buteomont/Acceleration-Logger/resources/FreeCAD/Acceleration Logger.step

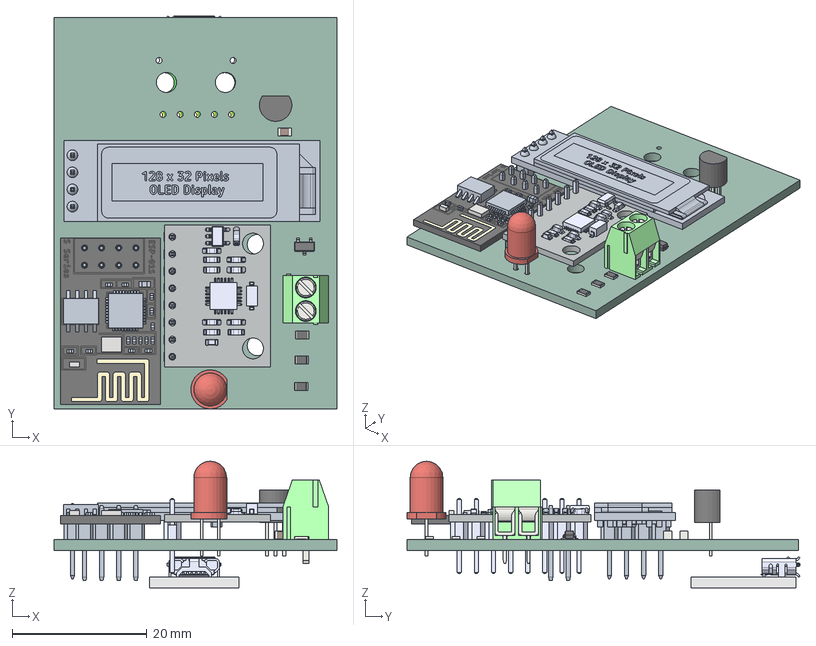
[picture p1: CAD file, 2025-04-22]
resources/FreeCAD/Acceleration Logger.step
42.0 x 58.3 x 18.8 mm
R_0805_2012Metric x 3
C_0805_2012Metric x 2
mpu
ESP-01S (ESP8266) Board Module v5
TO-92_Inline_Narrow
LED_D5.0mm
PCB_Terminal_Block_2-P3.5
SOT_23
Mico-USB_Breakout
Acceleration Logger_PCB
