buteomont/Acceleration-Logger/resources/FreeCAD/acceleration recorder-Bottom.stl

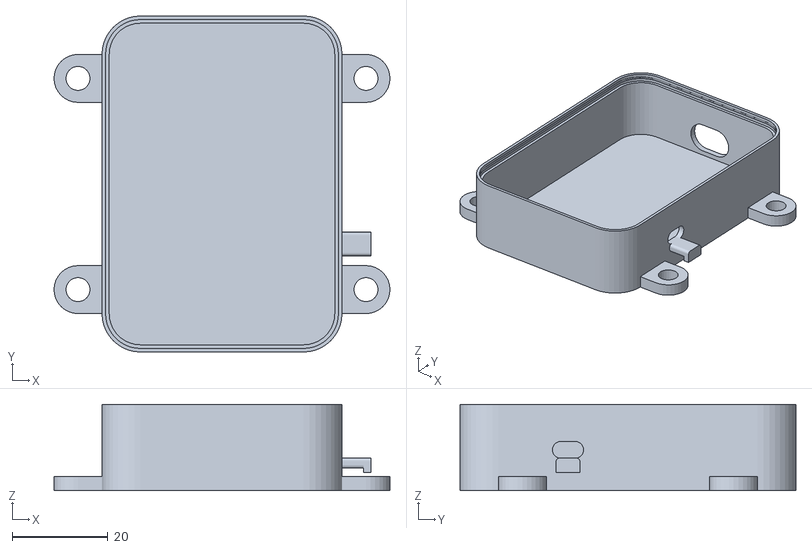
[picture p2: CAD file, 2025-04-22]
resources/FreeCAD/acceleration recorder-Bottom.stl
70.0 x 70.0 x 18.0
