buteomont/Acceleration-Logger/resources/FreeCAD/acceleration recorder-Top.stl

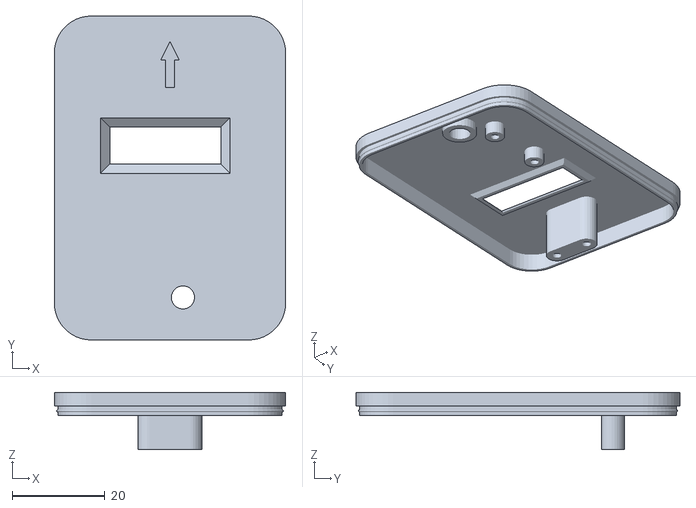
[picture p3: CAD file, 2025-04-22]
resources/FreeCAD/acceleration recorder-Top.stl
50.0 x 70.0 x 12.4
