buteomont/Acceleration-Logger/resources/FreeCAD/Standoffs-Sensor.stl

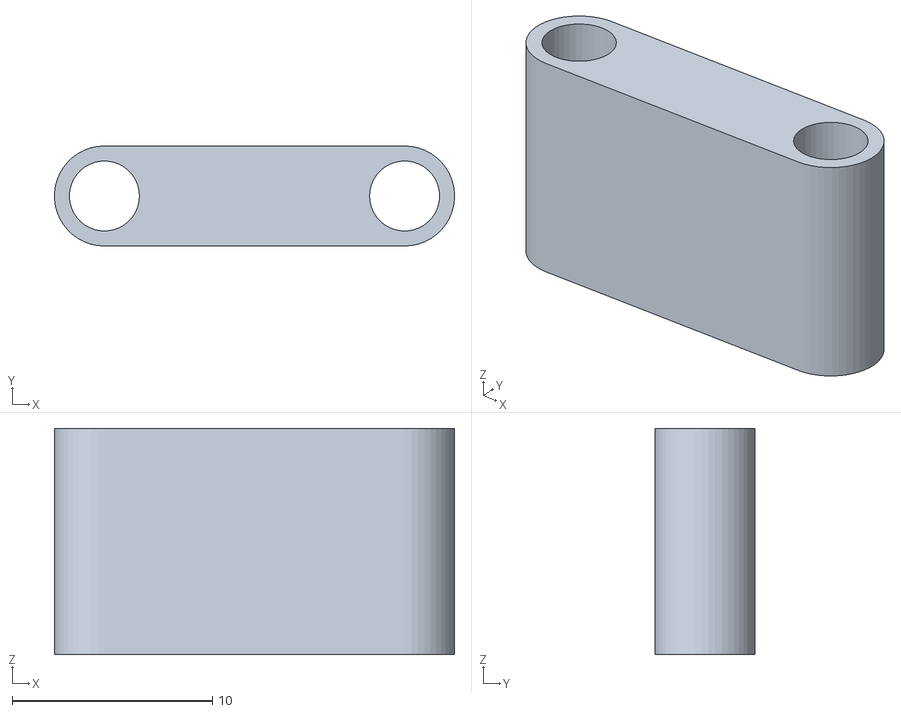
[picture p4: CAD file, 2025-03-28]
resources/FreeCAD/Standoffs-Sensor.stl
20.0 x 5.00 x 11.3
