buteomont/Acceleration-Logger/resources/FreeCAD/Standoffs-Display.stl

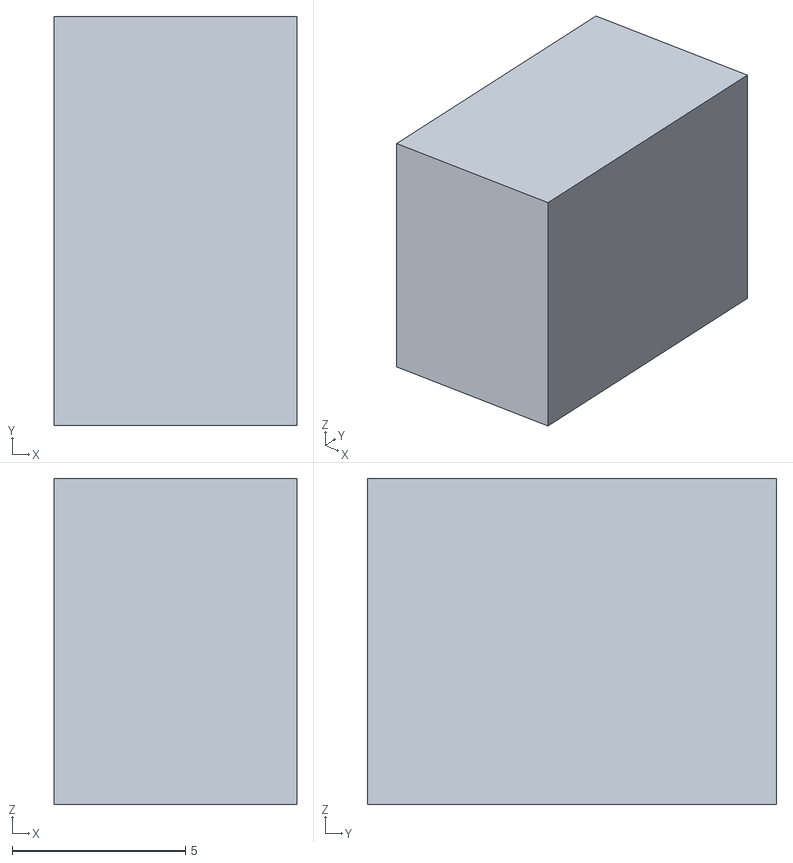
[picture p5: CAD file, 2025-03-28]
resources/FreeCAD/Standoffs-Display.stl
7.00 x 11.8 x 9.40
