buteomont/Acceleration-Logger/resources/FreeCAD/Standoffs.FCStd

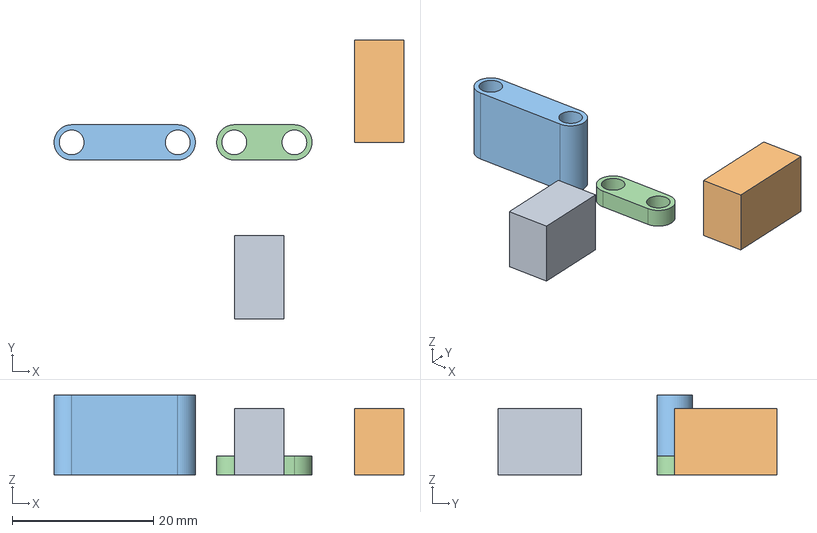
[picture p6: CAD file, 2025-03-28]
resources/FreeCAD/Standoffs.FCStd
49.5 x 39.5 x 11.3 mm
Display
Processor
Sensor
USB
