buteomont/Acceleration-Logger/resources/FreeCAD/Standoffs-USB.stl

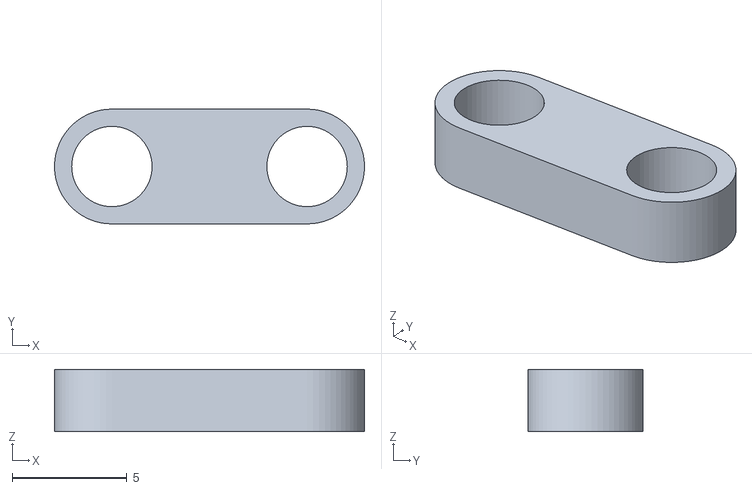
[picture p7: CAD file, 2025-03-28]
resources/FreeCAD/Standoffs-USB.stl
13.5 x 5.00 x 2.70
