buteomont/Acceleration-Logger/resources/FreeCAD/Standoffs-Processor.stl

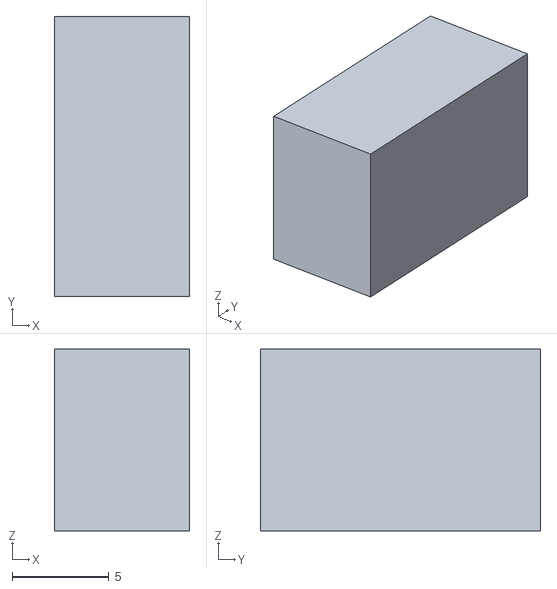
[picture p8: CAD file, 2025-03-28]
resources/FreeCAD/Standoffs-Processor.stl
7.00 x 14.5 x 9.40
