buteomont/Acceleration-Logger/(list of files, cad)

Other CAD files:
resources/FreeCAD/acceleration recorder.FCStd
