buteomont/Acceleration-Logger/resources/kicad/Acceleration Logger/Acceleration Logger.kicad_pcb

## KiCad design resources/kicad/Acceleration Logger/Acceleration Logger.kicad_pcb (2025-04-22)

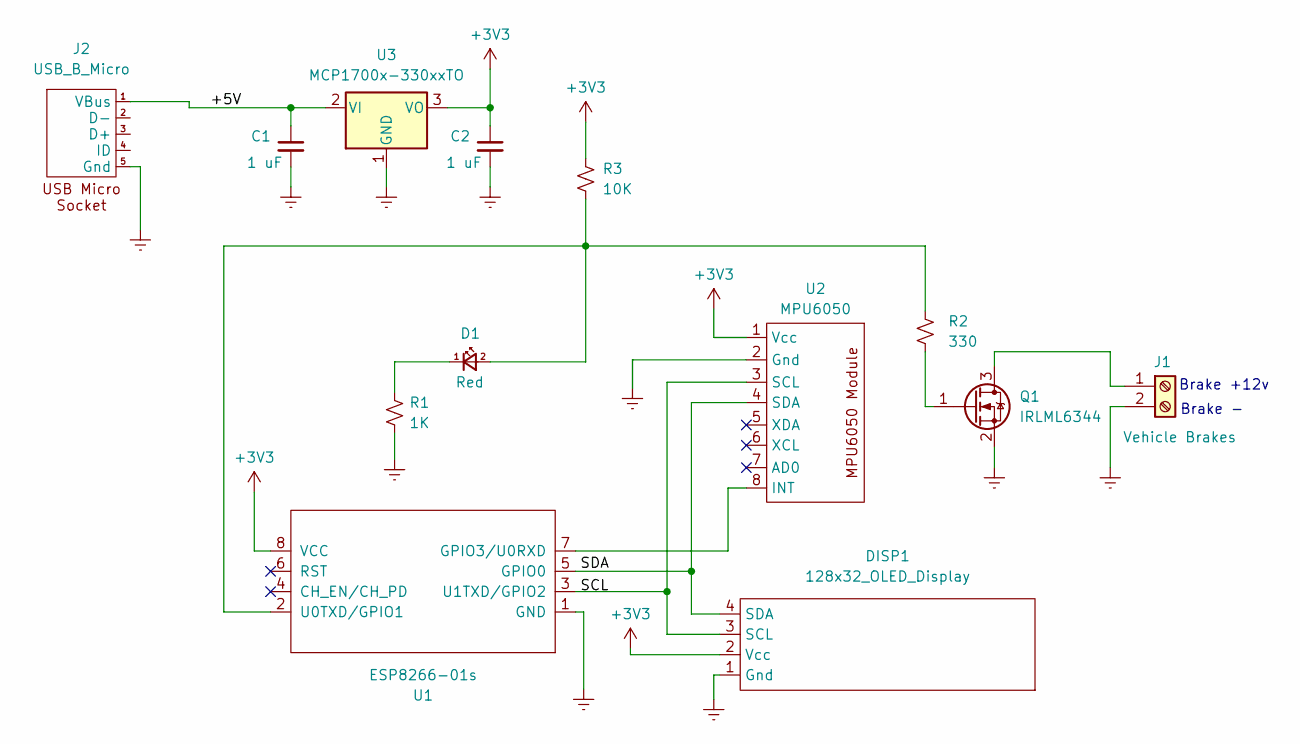
[picture p9: schematic Acceleration Logger.kicad_sch, Acceleration Logger and Indicator]

Parts:
C1, C2: 1 uF; C_0805_2012Metric_Pad1.18x1.45mm_HandSolder
D1: Red; LED_D5.0mm
DISP1: 128x32_OLED_Display; OLED_0.91_128x32
J1: Vehicle Brakes; KF350 2 Pin Terminal Block
J2: USB_B_Micro; USB Micro Breakout Board
Q1: IRLML6344; SOT-23
R1: 1K; R_0805_2012Metric_Pad1.20x1.40mm_HandSolder
R2: 330; R_0805_2012Metric_Pad1.20x1.40mm_HandSolder
R3: 10K; R_0805_2012Metric_Pad1.20x1.40mm_HandSolder
U1: ESP8266-01s
U2: MPU6050; MPU6050_Accelerometer_Module
U3: MCP1700x-330xxTO; TO-92_Inline

Connections:
+3V3: C2.1, DISP1.2 (Vcc), R3.1, U1.8 (VCC), U2.1 (Vcc), U3.3 (VO)
/+5V: C1.1, J2.1 (VBus), U3.2 (VI)
/SDA: DISP1.4 (SDA), U1.5 (GPIO0), U2.4 (SDA)
Earth: C1.2, C2.2, DISP1.1 (Gnd), J1.2, J2.5 (Gnd), Q1.2 (S), R1.2, U1.1 (GND), U2.2 (Gnd), U3.1 (GND)
unnamed: D1.2 (A), R2.1, R3.2, U1.2 (U0TXD/GPIO1)
unnamed: D1.1 (K), R1.1
unnamed: DISP1.3 (SCL), U1.3 (U1TXD/GPIO2), U2.3 (SCL)
unnamed: J1.1, Q1.3 (D)
unnamed: Q1.1 (G), R2.2
unnamed: U1.7 (GPIO3/U0RXD), U2.8 (INT)

Notes on the sheet:
Brake -
Brake +12v

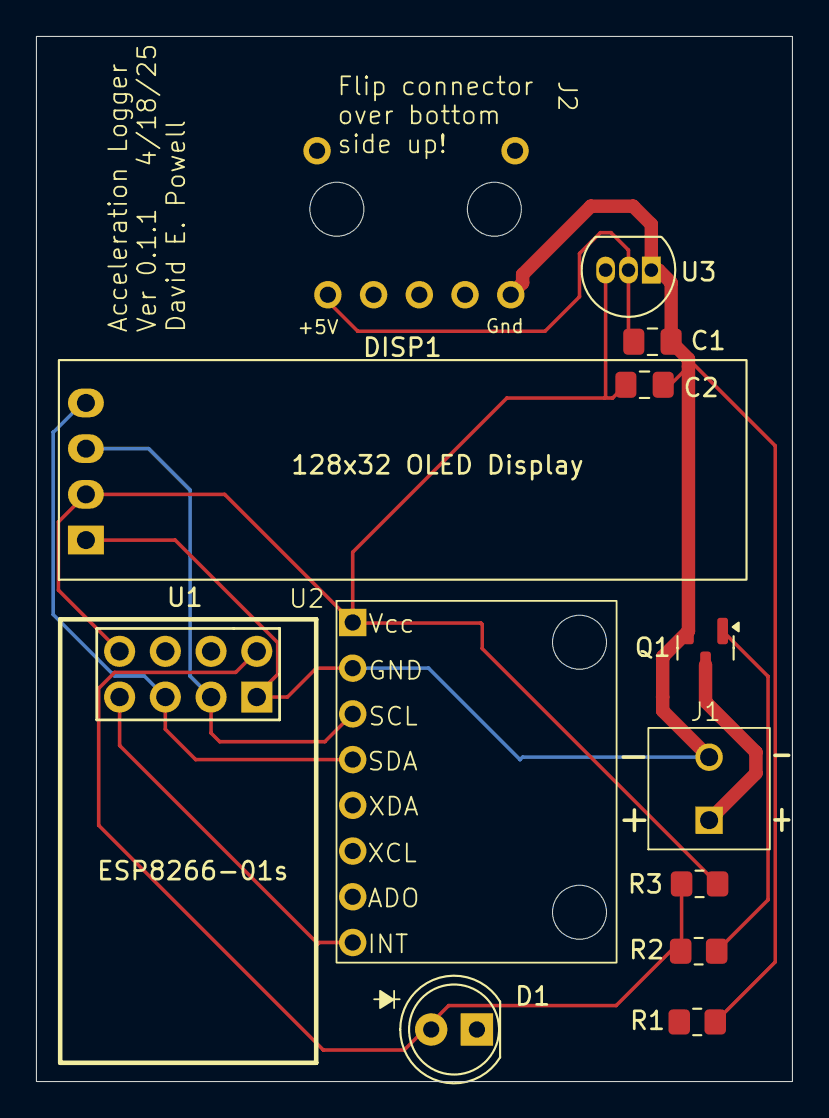
[picture p10: board Acceleration Logger.kicad_pcb from above]

Board: 2 copper layers, 42.0 x 58.1 mm, 13 parts (1 on the bottom side), 10 nets.
