buteomont/Acceleration-Logger/(commit log)

2025-03-28 Many updates
    [Acceleration Logger-B_Cu.gbr, Acceleration Logger-B_Mask.gbr, Acceleration Logger-B_Paste.gbr, Acceleration Logger-B_Silkscreen.gbr, Acceleration Logger-Edge_Cuts.gbr, Acceleration Logger-F_Cu.gbr, Acceleration Logger-F_Mask.gbr, Acceleration Logger-F_Paste.gbr]
2025-04-04 Minor fixes all around
    [acceleration recorder-Bottom.stl, acceleration recorder.FCStd]
2025-04-17 Board updates
    [Acceleration Logger-B_Cu.gbr, Acceleration Logger-B_Mask.gbr, Acceleration Logger-B_Paste.gbr, Acceleration Logger-B_Silkscreen.gbr, Acceleration Logger-Edge_Cuts.gbr, Acceleration Logger-F_Cu.gbr, Acceleration Logger-F_Mask.gbr, Acceleration Logger-F_Paste.gbr]
2025-04-22 Added "set level" feature. Changed LED to T1-3/4 size
    [Acceleration Logger-B_Cu.gbr, Acceleration Logger-B_Mask.gbr, Acceleration Logger-B_Paste.gbr, Acceleration Logger-B_Silkscreen.gbr, Acceleration Logger-Edge_Cuts.gbr, Acceleration Logger-F_Cu.gbr, Acceleration Logger-F_Mask.gbr, Acceleration Logger-F_Paste.gbr]
